Thieso/freq-analyzer/results/setup1.jpg

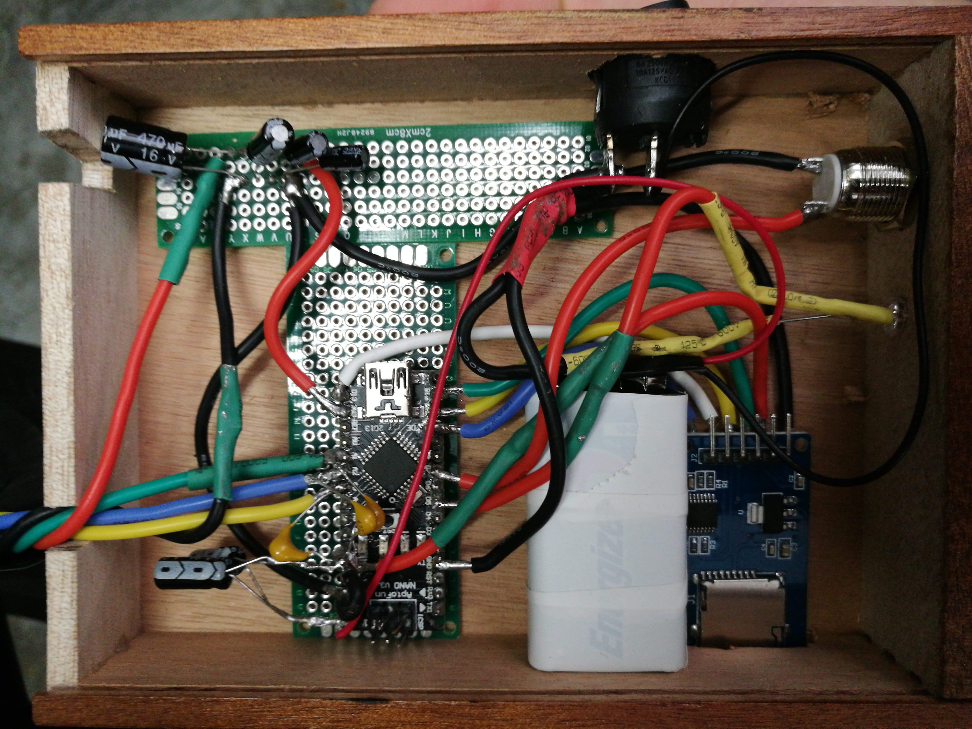
results/setup1.jpg
