Thieso/freq-analyzer/results/setup3.jpg

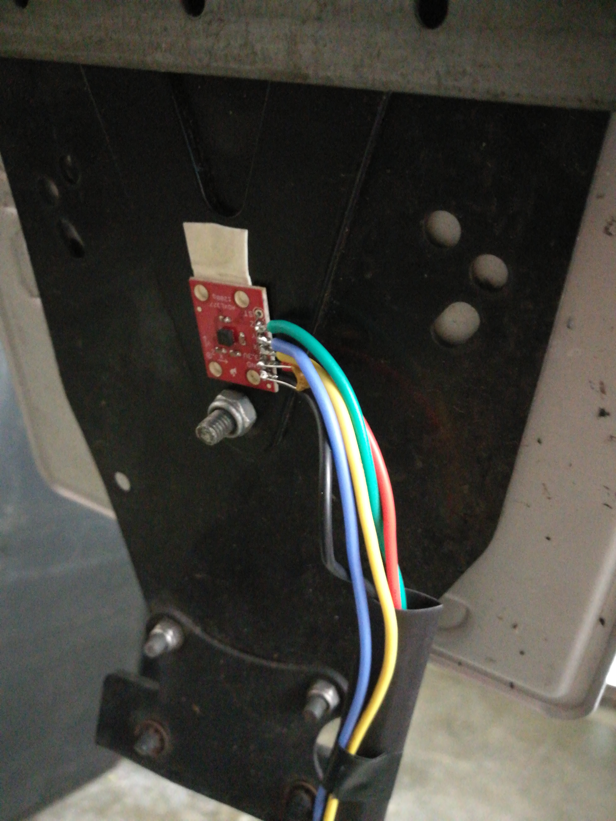
results/setup3.jpg
