Thieso/freq-analyzer/results/visualized_data_X.jpg

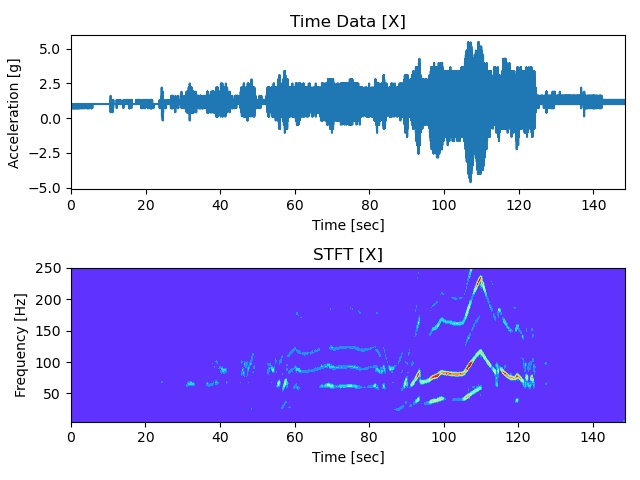
results/visualized_data_X.jpg
