Thieso/freq-analyzer/results/visualized_data_Y.jpg

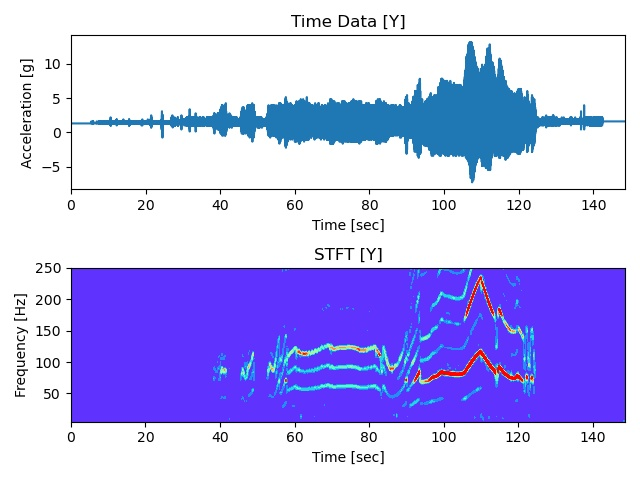
results/visualized_data_Y.jpg
