Thieso/freq-analyzer/results/visualized_data_Z.jpg

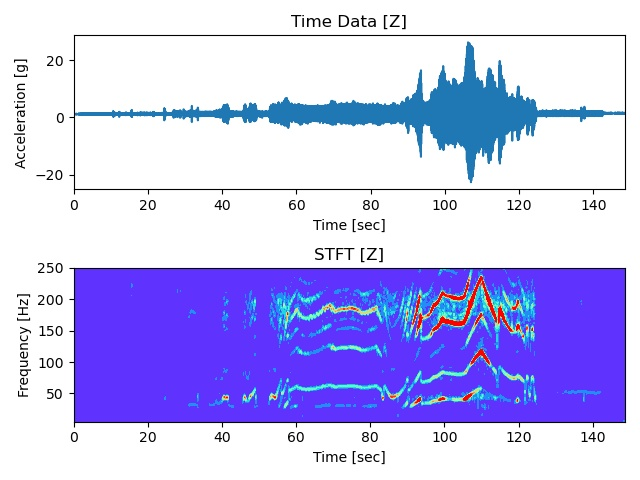
results/visualized_data_Z.jpg
