Thieso/freq-analyzer/(commit log)

2020-07-05 Added README with project description and wiring and dependencies. Added comments to Arduino code.
2020-07-06 Added pics and gifs in README for license plate example. Further improved post processing scripts and arduino script with small fixes
2020-07-10 Added tags file to gitignore Implemented kalman filter in the arduino code and adapted post post_processing scripts to work with the new arduino output. The arduino now sends the raw acceleration dat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
2020-07-26 Added stft script, which uses interpolation to create more consistent FFTs (needs testing), adapted arduino ino file (will be optimized further in the future)
2020-07-28 Changed arduino code to either log to sd card or send to serial for live plotting adapted live plotting scripts for better results (interpolating data) added STFT live plotting script added file to p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
2020-07-30 Removed unessecary libraries from project Switches to Sparkfun ADXL377 sensor (analog) Improved logging script (for now only logging, no live plots), for fast logging using the analog bin logger from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
2020-08-03 Improved README to facilitate the new changes. Added plots for motorcycle license plate example. Added picture for setup with the license plate. Deleted live plotting scripts since live plotting is t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
    [main_accel_serial.cpp, visualize_log_file_data.py]
2020-08-25 Added data directory so as not to lose any data.
    [analog00.csv, analog01.csv, analog02.csv, analog03.csv, analog04.csv, analog05.csv, analog06.csv, analog07.csv]
